chrismerck/autokiln/README.md

# autokiln
Controller for Small Wood-Drying Kilns
