chrismerck/autokiln/hardware/autokiln.pdf

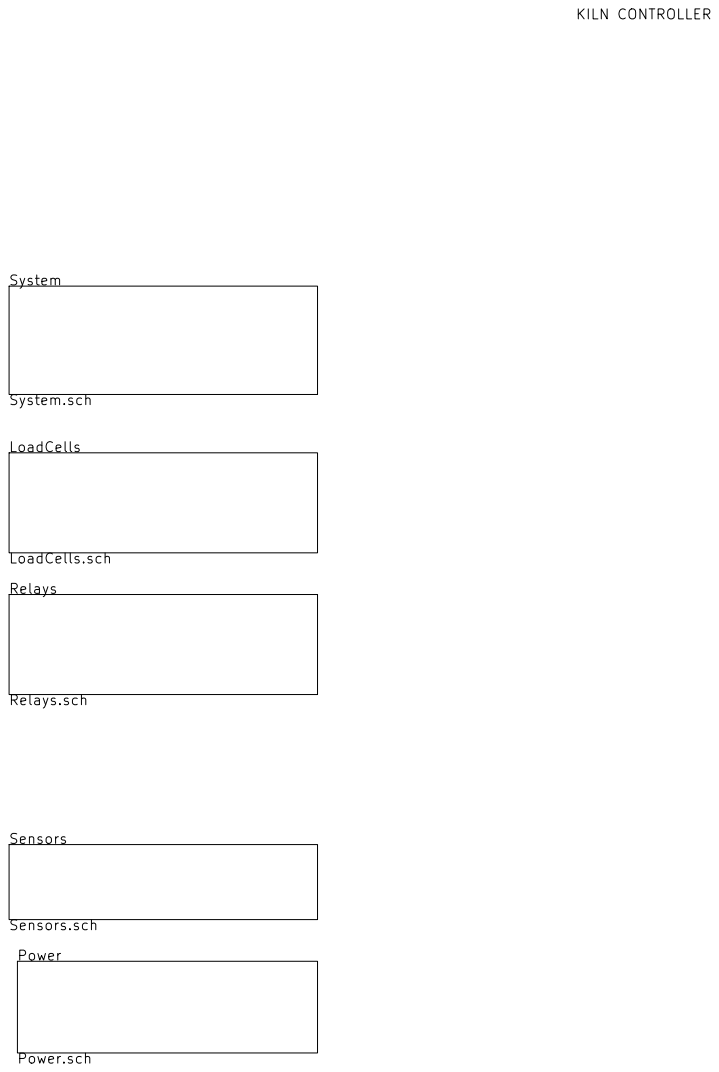
[picture p1: page 1]

Sensors.sch Power Power.sch

File: autokiln.sch Sheet: / Chris Merck

Id: 1/6 Title: Wood Drying Kiln Controller "AutoKiln"

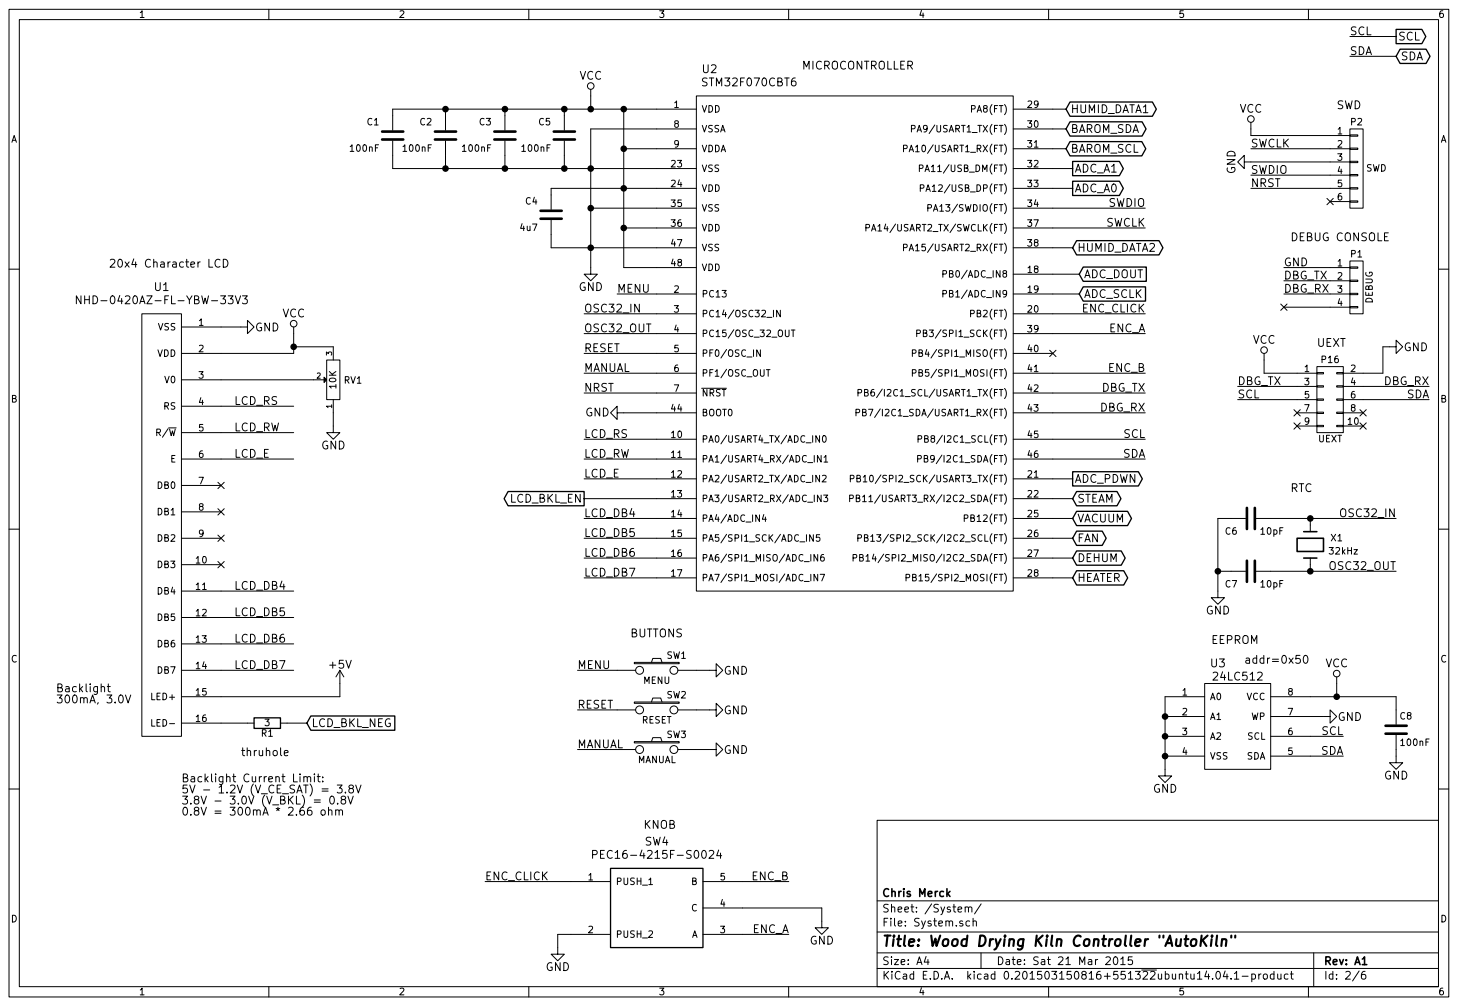
[picture p2: page 2]

thruhole Backlight Current Limit:

Sheet: /System/ Chris Merck

File: System.sch
Id: 2/6 Title: Wood Drying Kiln Controller "AutoKiln"

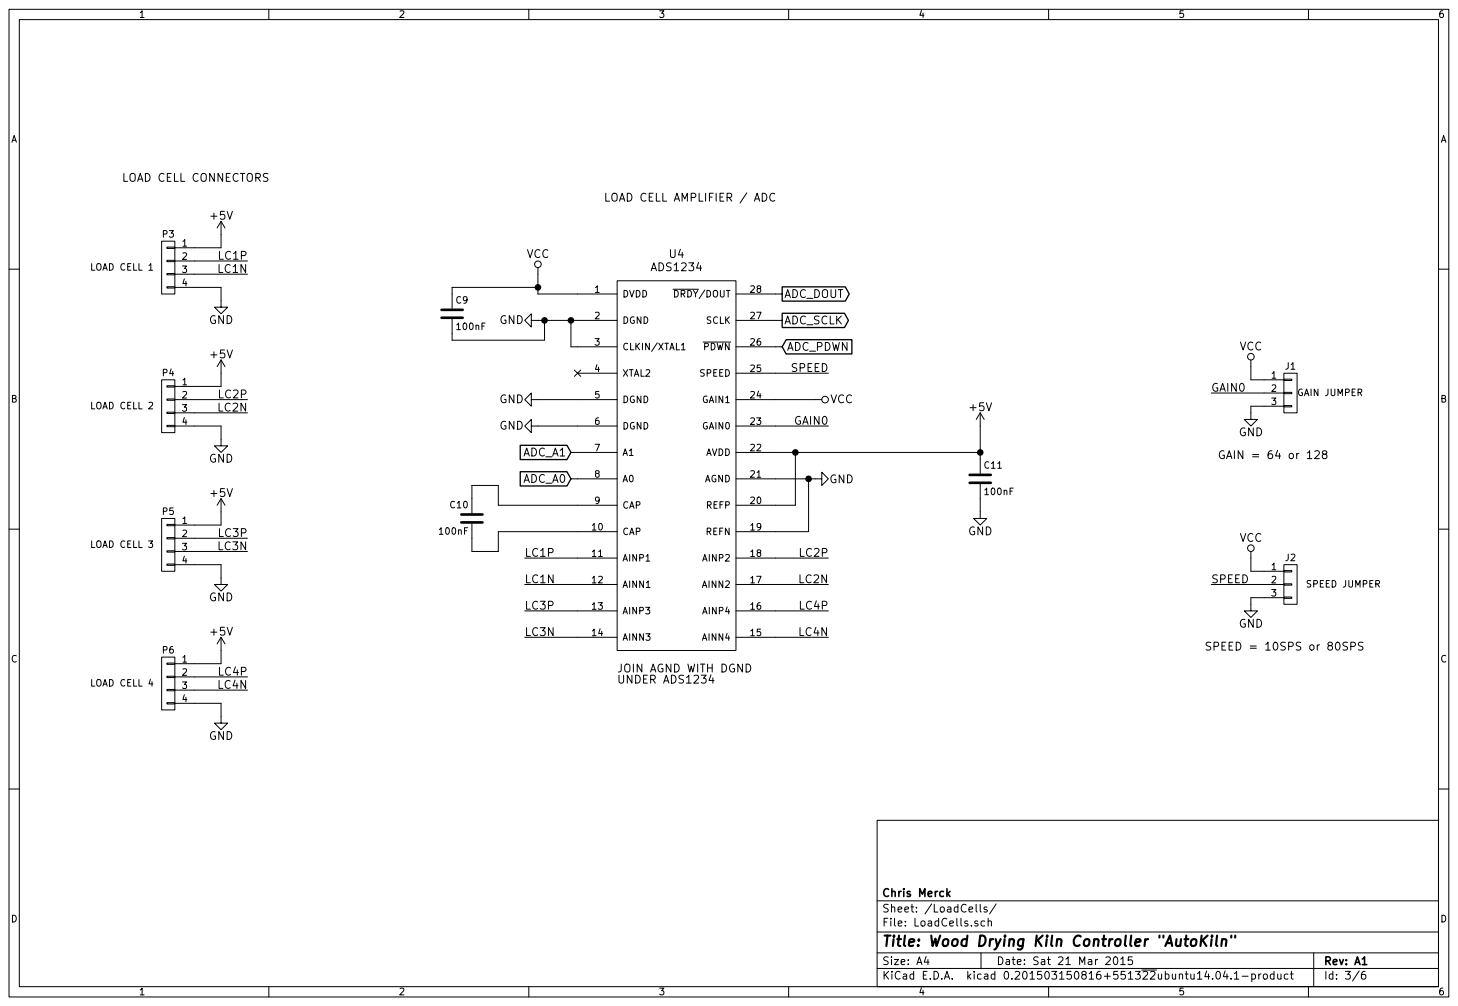
[picture p3: page 3]

LOAD CELL AMPLIFIER / ADC

JOIN AGND WITH DGND
UNDER ADS1234

File: LoadCells.sch Sheet: /LoadCells/ Chris Merck

Id: 3/6 Title: Wood Drying Kiln Controller "AutoKiln"

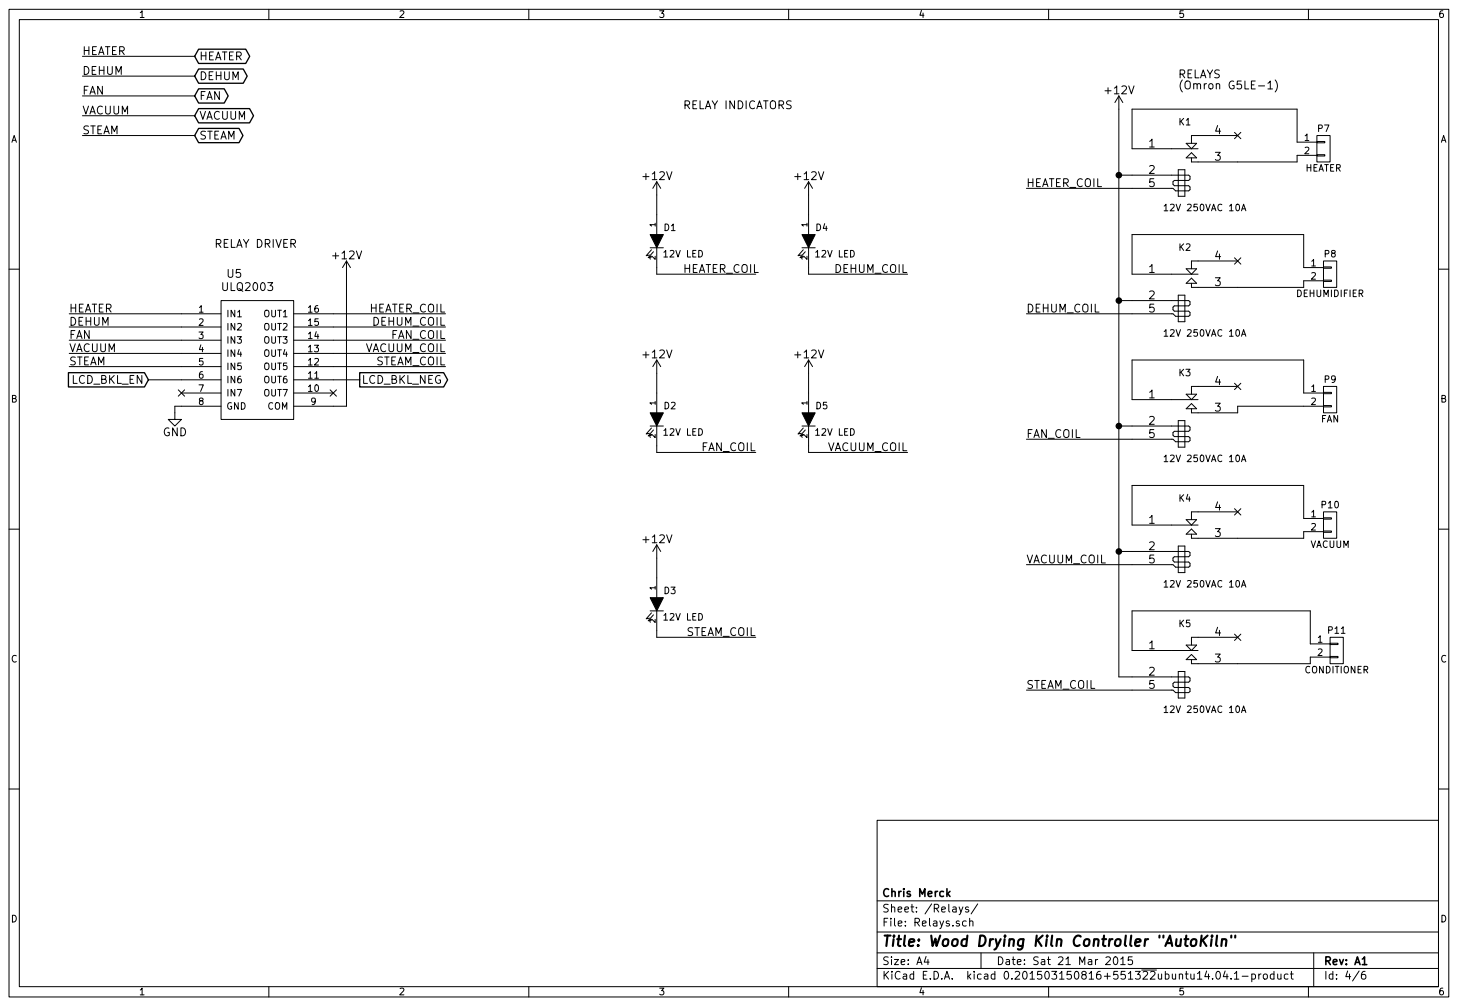
[picture p4: page 4]

FAN | IN3 3 | | FAN_COIL

IN4 4 | VACUUM_COIL

STEAM_COIL

Sheet: /Relays/ Chris Merck

File: Relays.sch
Id: 4/6 Title: Wood Drying Kiln Controller "AutoKiln"

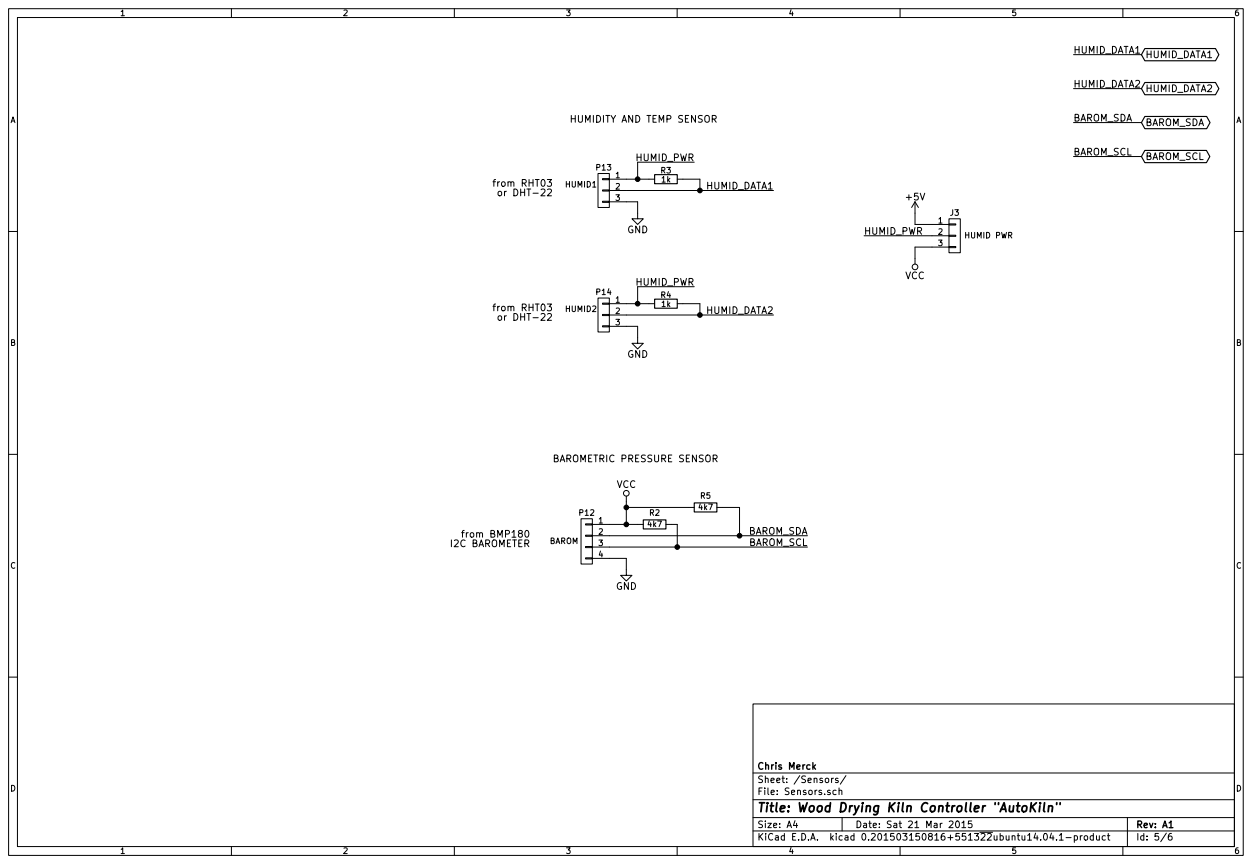
[picture p5: page 5]

HUMIDITY AND TEMP SENSOR

File: Sensors.sch Sheet: /Sensors/ Chris Merck

Id: 5/6 Title: Wood Drying Kiln Controller "AutoKiln"

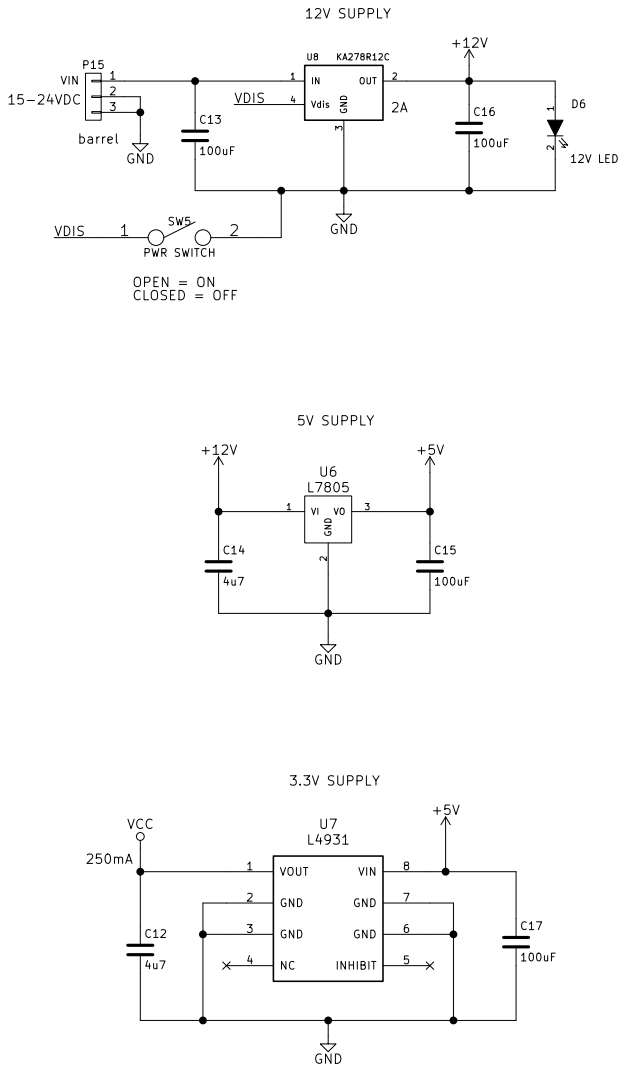
[picture p6: page 6]

File: Power.sch Sheet: /Power/ Chris Merck

Id: 6/6 Title: Wood Drying Kiln Controller "AutoKiln"
