chrismerck/autokiln/hardware/autokiln.kicad_pcb

## KiCad design hardware/autokiln.kicad_pcb (2015-04-01)

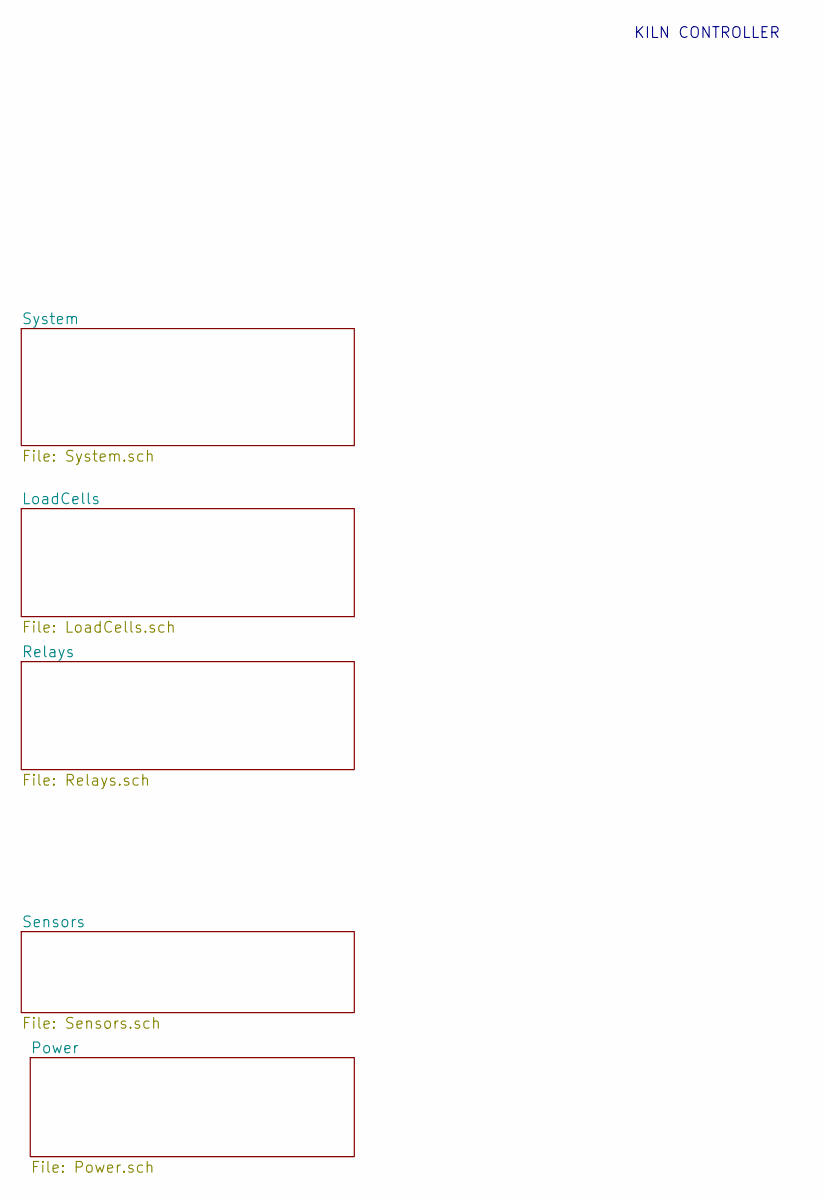
[picture p7: schematic autokiln.sch, Wood Drying Kiln Controller \"AutoKiln\"]

Notes on the sheet:
KILN CONTROLLER

Schematic: System.sch, Wood Drying Kiln Controller \"AutoKiln\"

Parts:
C1, C2, C3, C5, C8: 100nF; R_0805_HandSoldering
C4: 4u7; R_0805_HandSoldering
C6, C7: 10pF; R_0805_HandSoldering
P1: DEBUG; Pin_Header_Straight_1x04
P2: SWD; Pin_Header_Straight_1x06
P16: UEXT; Pin_Header_Straight_2x05
R1: 3; Resistor_Horizontal_RM10mm
RV1: 10K; BOURNS_TRIMMER_3303W
SW1: MENU; CK_Button_D6R
SW2: RESET; CK_Button_D6R
SW3: MANUAL; CK_Button_D6R
SW4: PEC16-4215F-S0024; BOURNS_Encoder_PEC16
U1: NHD-0420AZ-FL-YBW-33V3; NHD-0420AZ-FL-GBW-33V3
U2: STM32F070CBT6; LQFP-48_7x7mm_Pitch0.5mm
U3: 24LC512; SOIC-8_3.9x4.9mm_Pitch1.27mm
X1: 32kHz; Abracon_32KHz

Connections:
+5V: U1.15 (LED+); also elsewhere on the board
/System/DBG_RX: P1.3, P16.4, U2.43 (PB7/I2C1_SDA/USART1_RX(FT))
/System/DBG_TX: P1.2, P16.3, U2.42 (PB6/I2C1_SCL/USART1_TX(FT))
/System/ENC_A: SW4.3 (A), U2.39 (PB3/SPI1_SCK(FT))
/System/ENC_B: SW4.5 (B), U2.41 (PB5/SPI1_MOSI(FT))
/System/ENC_CLICK: SW4.1 (PUSH_1), U2.20 (PB2(FT))
/System/LCD_DB4: U1.11 (DB4), U2.14 (PA4/ADC_IN4)
/System/LCD_DB5: U1.12 (DB5), U2.15 (PA5/SPI1_SCK/ADC_IN5)
/System/LCD_DB6: U1.13 (DB6), U2.16 (PA6/SPI1_MISO/ADC_IN6)
/System/LCD_DB7: U1.14 (DB7), U2.17 (PA7/SPI1_MOSI/ADC_IN7)
/System/LCD_E: U1.6 (E), U2.12 (PA2/USART2_TX/ADC_IN2)
/System/LCD_RS: U1.4 (RS), U2.10 (PA0/USART4_TX/ADC_IN0)
/System/LCD_RW: U1.5 (R/~W), U2.11 (PA1/USART4_RX/ADC_IN1)
/System/MANUAL: SW3.1, U2.6 (PF1/OSC_OUT)
/System/MENU: SW1.1, U2.2 (PC13)
/System/NRST: P2.5, U2.7 (~NRST)
/System/OSC32_IN: C6.2, U2.3 (PC14/OSC32_IN), X1.1
/System/OSC32_OUT: C7.2, U2.4 (PC15/OSC_32_OUT), X1.2
/System/RESET: SW2.1, U2.5 (PF0/OSC_IN)
/System/SWCLK: P2.2, U2.37 (PA14/USART2_TX/SWCLK(FT))
/System/SWDIO: P2.4, U2.34 (PA13/SWDIO(FT))
ADC_A0: U2.33 (PA12/USB_DP(FT)); also elsewhere on the board
ADC_A1: U2.32 (PA11/USB_DM(FT)); also elsewhere on the board
ADC_DOUT: U2.18 (PB0/ADC_IN8); also elsewhere on the board
ADC_PDWN: U2.21 (PB10/SPI2_SCK/USART3_TX(FT)); also elsewhere on the board
ADC_SCLK: U2.19 (PB1/ADC_IN9); also elsewhere on the board
BAROM_SCL: U2.31 (PA10/USART1_RX(FT)); also elsewhere on the board
BAROM_SDA: U2.30 (PA9/USART1_TX(FT)); also elsewhere on the board
DEHUM: U2.27 (PB14/SPI2_MISO/I2C2_SDA(FT)); also elsewhere on the board
FAN: U2.26 (PB13/SPI2_SCK/I2C2_SCL(FT)); also elsewhere on the board
GND: C1.2, C2.2, C3.2, C4.2, C5.2, C6.1, C7.1, C8.2, P1.1, P2.3, P16.2, RV1.1, SW1.2, SW2.2, SW3.2, SW4.2 (PUSH_2), SW4.4 (C), U1.1 (VSS), U2.8 (VSSA), U2.23 (VSS), U2.35 (VSS), U2.44 (BOOT0), U2.47 (VSS), U3.1 (A0), U3.2 (A1), U3.3 (A2), U3.4 (VSS), U3.7 (WP); also elsewhere on the board
HEATER: U2.28 (PB15/SPI2_MOSI(FT)); also elsewhere on the board
HUMID_DATA1: U2.29 (PA8(FT)); also elsewhere on the board
HUMID_DATA2: U2.38 (PA15/USART2_RX(FT)); also elsewhere on the board
LCD_BKL_EN: U2.13 (PA3/USART2_RX/ADC_IN3); also elsewhere on the board
LCD_BKL_NEG: R1.1; also elsewhere on the board
unnamed: R1.2, U1.16 (LED-)
unnamed: RV1.2, U1.3 (V0)
SCL: P16.5, U2.45 (PB8/I2C1_SCL(FT)), U3.6 (SCL)
SDA: P16.6, U2.46 (PB9/I2C1_SDA(FT)), U3.5 (SDA)
STEAM: U2.22 (PB11/USART3_RX/I2C2_SDA(FT)); also elsewhere on the board
VACUUM: U2.25 (PB12(FT)); also elsewhere on the board
VCC: C1.1, C2.1, C3.1, C4.1, C5.1, C8.1, P2.1, P16.1, RV1.3, U1.2 (VDD), U2.1 (VDD), U2.9 (VDDA), U2.24 (VDD), U2.36 (VDD), U2.48 (VDD), U3.8 (VCC); also elsewhere on the board

Notes on the sheet:
MICROCONTROLLER
EEPROM
addr=0x50
RTC
DEBUG CONSOLE
KNOB
SWD
BUTTONS
Backlight 300mA, 3.0V
20x4 Character LCD
thruhole
Backlight Current Limit: 5V - 1.2V (V_CE_SAT) = 3.8V 3.8V - 3.0V (V_BKL) = 0.8V 0.8V = 300mA * 2.66 ohm
UEXT

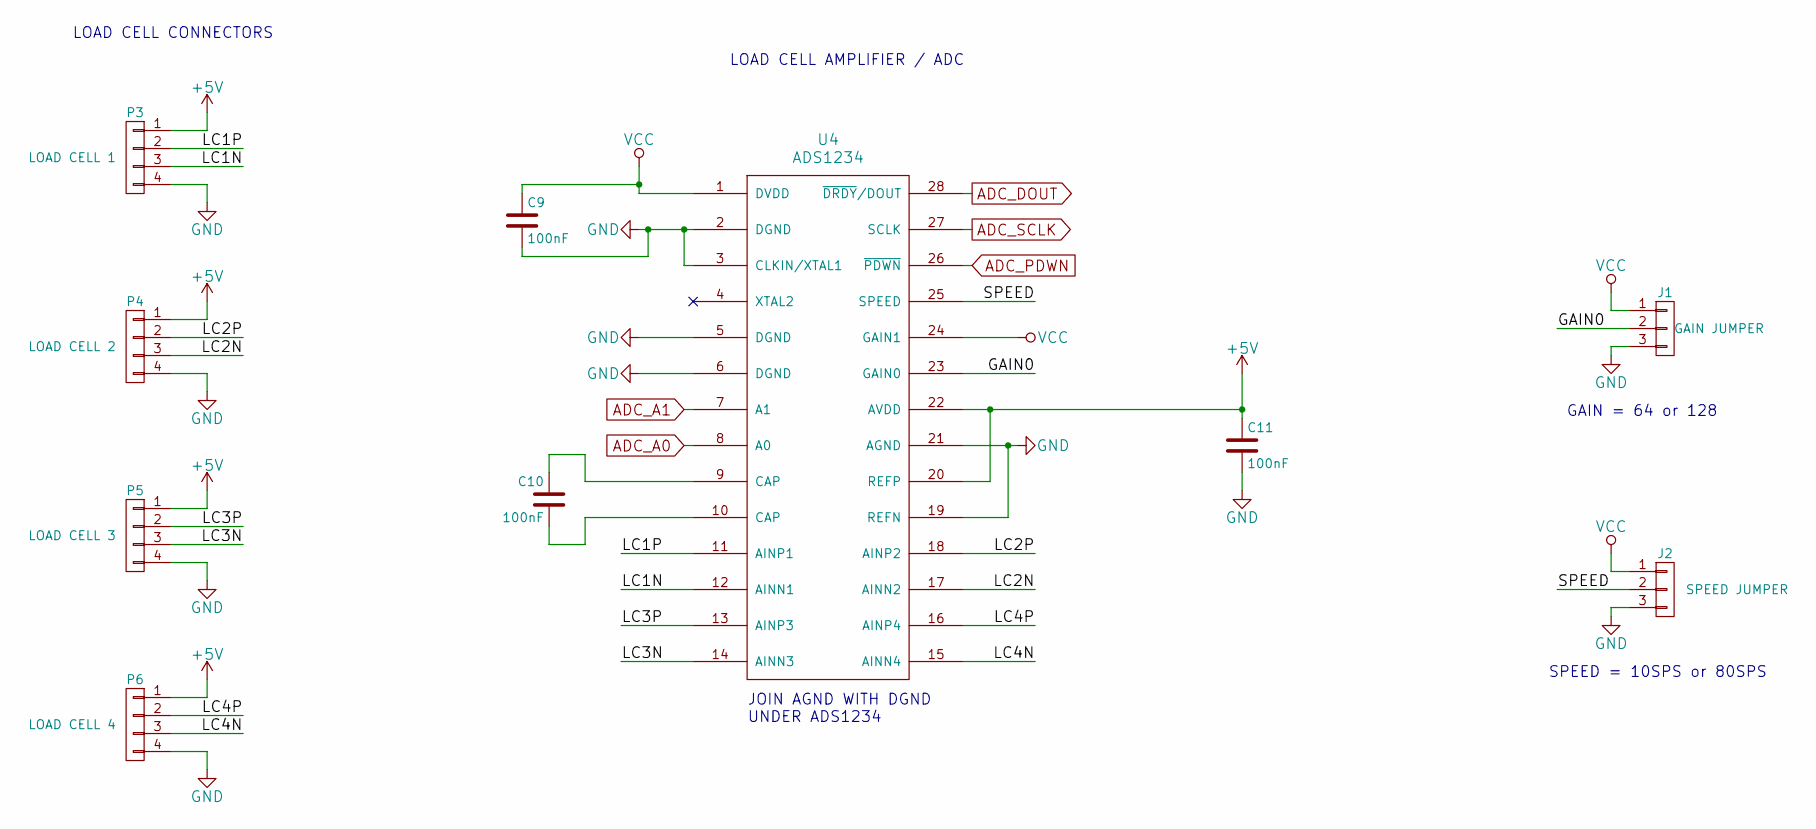
[picture p8: schematic LoadCells.sch, Wood Drying Kiln Controller \"AutoKiln\"]

Parts:
C9, C10, C11: 100nF; R_0805_HandSoldering
J1: GAIN JUMPER; Pin_Header_Straight_1x03
J2: SPEED JUMPER; Pin_Header_Straight_1x03
P3: LOAD CELL 1; ostoq047151
P4: LOAD CELL 2; ostoq047151
P5: LOAD CELL 3; ostoq047151
P6: LOAD CELL 4; ostoq047151
U4: ADS1234; TSSOP-28_4.4x9.7mm_Pitch0.65mm

Connections:
+5V: C11.1, P3.1, P4.1, P5.1, P6.1, U4.20 (REFP), U4.22 (AVDD); also elsewhere on the board
/LoadCells/GAIN0: J1.2, U4.23 (GAIN0)
/LoadCells/LC1N: P3.3, U4.12 (AINN1)
/LoadCells/LC1P: P3.2, U4.11 (AINP1)
/LoadCells/LC2N: P4.3, U4.17 (AINN2)
/LoadCells/LC2P: P4.2, U4.18 (AINP2)
/LoadCells/LC3N: P5.3, U4.14 (AINN3)
/LoadCells/LC3P: P5.2, U4.13 (AINP3)
/LoadCells/LC4N: P6.3, U4.15 (AINN4)
/LoadCells/LC4P: P6.2, U4.16 (AINP4)
/LoadCells/SPEED: J2.2, U4.25 (SPEED)
ADC_A0: U4.8 (A0); also elsewhere on the board
ADC_A1: U4.7 (A1); also elsewhere on the board
ADC_DOUT: U4.28 (~DRDY~/DOUT); also elsewhere on the board
ADC_PDWN: U4.26 (~PDWN); also elsewhere on the board
ADC_SCLK: U4.27 (SCLK); also elsewhere on the board
GND: C9.2, C11.2, J1.3, J2.3, P3.4, P4.4, P5.4, P6.4, U4.2 (DGND), U4.3 (CLKIN/XTAL1), U4.5 (DGND), U4.6 (DGND), U4.19 (REFN), U4.21 (AGND); also elsewhere on the board
unnamed: C10.1, U4.9 (CAP)
unnamed: C10.2, U4.10 (CAP)
VCC: C9.1, J1.1, J2.1, U4.1 (DVDD), U4.24 (GAIN1); also elsewhere on the board

Notes on the sheet:
JOIN AGND WITH DGND UNDER ADS1234
GAIN = 64 or 128
LOAD CELL CONNECTORS
LOAD CELL AMPLIFIER / ADC
SPEED = 10SPS or 80SPS

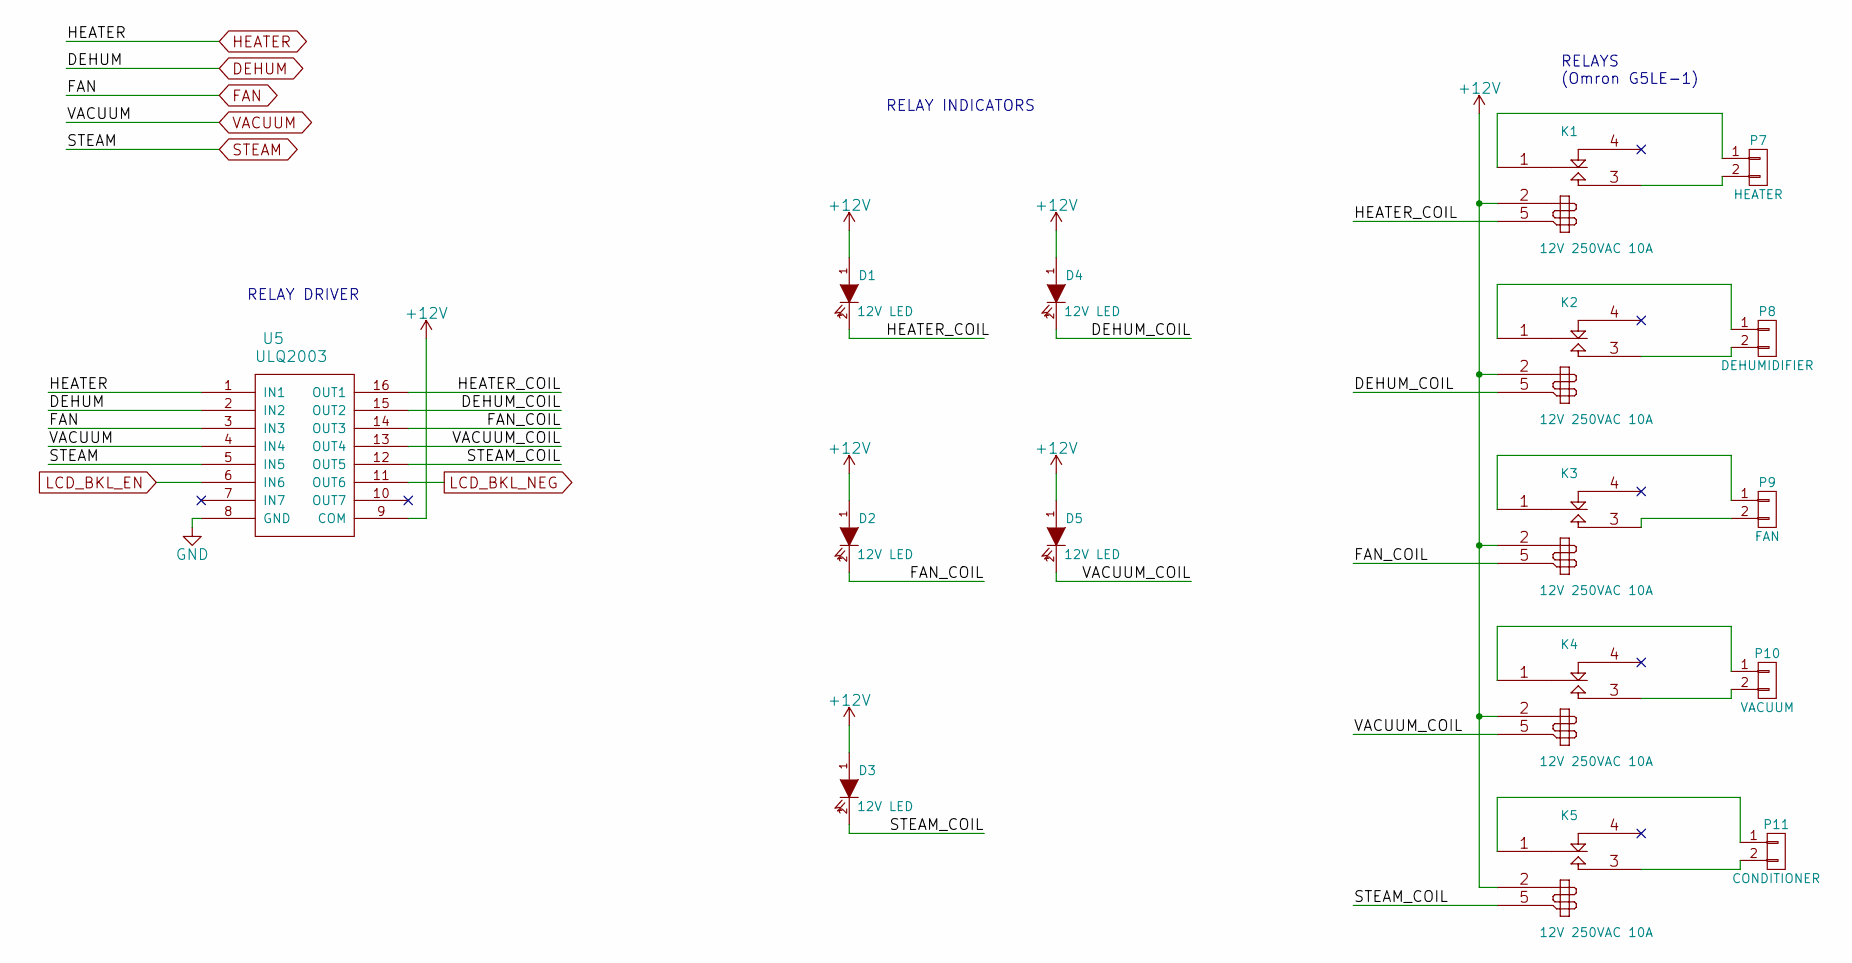
[picture p9: schematic Relays.sch, Wood Drying Kiln Controller \"AutoKiln\"]

Parts:
D1, D2, D3, D4, D5: 12V LED; Diode_LED_5mm_round_vertical
K1, K2, K3, K4, K5: 12V 250VAC 10A; Relay_SANYOU_SRD_Series_Form_C
P7: HEATER; OSTOQ020151
P8: DEHUMIDIFIER; OSTOQ020151
P9: FAN; OSTOQ020151
P10: VACUUM; OSTOQ020151
P11: CONDITIONER; OSTOQ020151
U5: ULQ2003; SO-16-N

Connections:
+12V: D1.1 (A), D2.1 (A), D3.1 (A), D4.1 (A), D5.1 (A), K1.2, K2.2, K3.2, K4.2, K5.2, U5.9 (COM); also elsewhere on the board
/Relays/DEHUM_COIL: D4.2 (K), K2.5, U5.15 (OUT2)
/Relays/FAN_COIL: D2.2 (K), K3.5, U5.14 (OUT3)
/Relays/HEATER_COIL: D1.2 (K), K1.5, U5.16 (OUT1)
/Relays/STEAM_COIL: D3.2 (K), K5.5, U5.12 (OUT5)
/Relays/VACUUM_COIL: D5.2 (K), K4.5, U5.13 (OUT4)
DEHUM: U5.2 (IN2); also elsewhere on the board
FAN: U5.3 (IN3); also elsewhere on the board
GND: U5.8 (GND); also elsewhere on the board
HEATER: U5.1 (IN1); also elsewhere on the board
LCD_BKL_EN: U5.6 (IN6); also elsewhere on the board
LCD_BKL_NEG: U5.11 (OUT6); also elsewhere on the board
unnamed: K1.1, P7.1
unnamed: K1.3, P7.2
unnamed: K2.1, P8.1
unnamed: K2.3, P8.2
unnamed: K3.1, P9.1
unnamed: K3.3, P9.2
unnamed: K4.1, P10.1
unnamed: K4.3, P10.2
unnamed: K5.1, P11.1
unnamed: K5.3, P11.2
STEAM: U5.5 (IN5); also elsewhere on the board
VACUUM: U5.4 (IN4); also elsewhere on the board

Notes on the sheet:
RELAYS (Omron G5LE-1)
RELAY DRIVER
RELAY INDICATORS

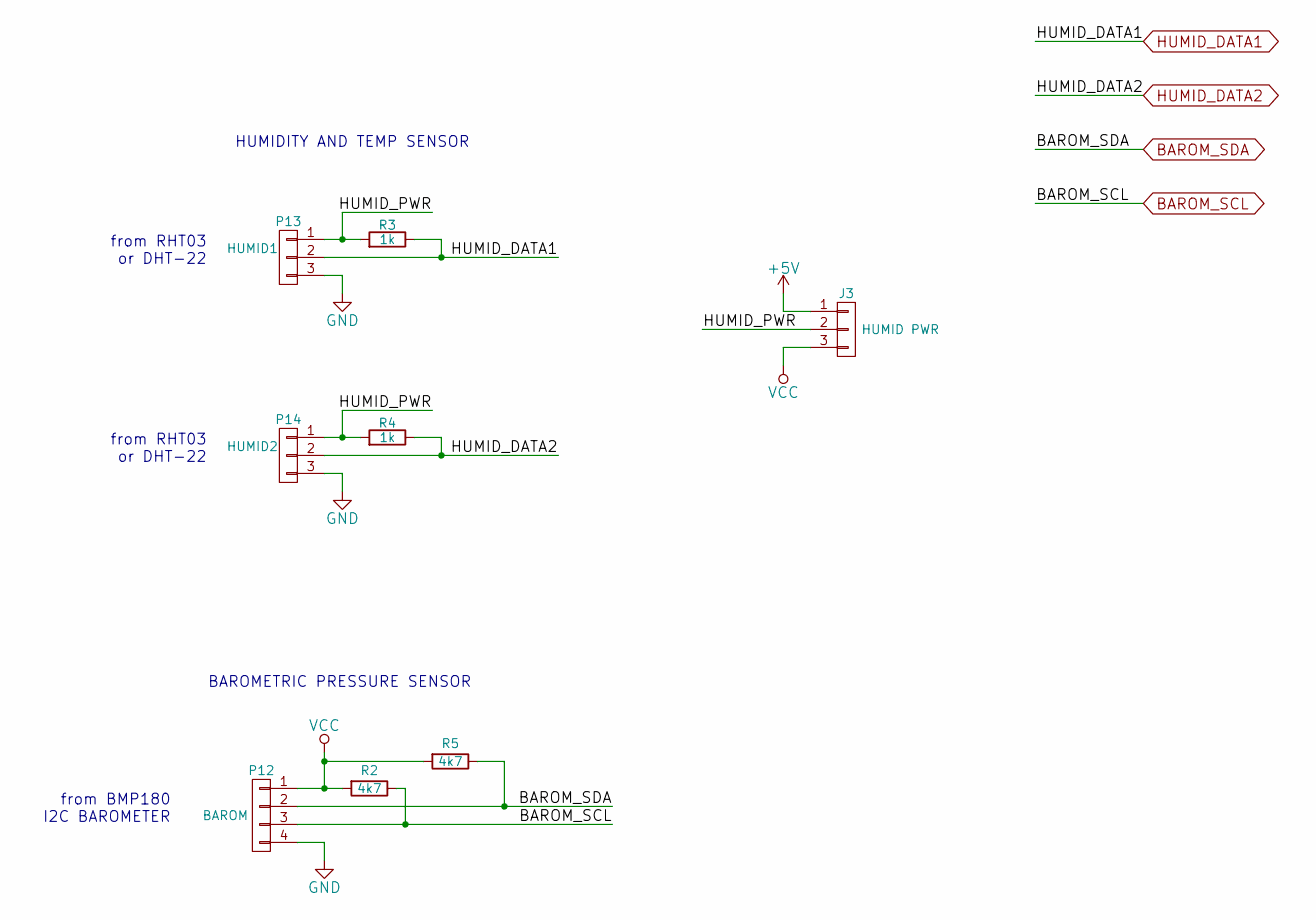
[picture p10: schematic Sensors.sch, Wood Drying Kiln Controller \"AutoKiln\"]

Parts:
J3: HUMID PWR; Pin_Header_Straight_1x03
P12: BAROM; ostoq047151
P13: HUMID1; OSTOQ037151
P14: HUMID2; OSTOQ037151
R2, R5: 4k7; R_0805_HandSoldering
R3, R4: 1k; R_0805_HandSoldering

Connections:
+5V: J3.1; also elsewhere on the board
/Sensors/HUMID_PWR: J3.2, P13.1, P14.1, R3.2, R4.2
BAROM_SCL: P12.3, R2.1; also elsewhere on the board
BAROM_SDA: P12.2, R5.1; also elsewhere on the board
GND: P12.4, P13.3, P14.3; also elsewhere on the board
HUMID_DATA1: P13.2, R3.1; also elsewhere on the board
HUMID_DATA2: P14.2, R4.1; also elsewhere on the board
VCC: J3.3, P12.1, R2.2, R5.2; also elsewhere on the board

Notes on the sheet:
from RHT03 or DHT-22
HUMIDITY AND TEMP SENSOR
from BMP180 I2C BAROMETER
BAROMETRIC PRESSURE SENSOR

Schematic: Power.sch, Wood Drying Kiln Controller \"AutoKiln\"

Parts:
C12, C14: 4u7; R_0805_HandSoldering
C13, C15, C16, C17: 100uF; KEMET_100uF_25V
D6: 12V LED; Diode_LED_5mm_round_vertical
P15: VIN; CUI_PJ-002AH_DC_PWR_JACK
SW5: PWR SWITCH; ESwitch-100SP1T1B4M2QE
U6: L7805; TO-220_SG
U7: L4931; SO-8
U8: KA278R12C; TO-220F-4L

Connections:
+5V: C15.1, C17.1, U6.3, U7.8 (VIN); also elsewhere on the board
+12V: C14.1, C16.1, D6.1 (A), U6.1, U8.2 (OUT); also elsewhere on the board
/Power/VDIS: SW5.1, U8.4 (Vdis)
GND: C12.2, C13.2, C14.2, C15.2, C16.2, C17.2, D6.2 (K), P15.2, P15.3, SW5.2, U6.2, U7.2 (GND), U7.3 (GND), U7.6 (GND), U7.7 (GND), U8.3 (GND); also elsewhere on the board
unnamed: C13.1, P15.1, U8.1 (IN)
VCC: C12.1, U7.1 (VOUT); also elsewhere on the board

Notes on the sheet:
15-24VDC
OPEN = ON CLOSED = OFF
12V SUPPLY
250mA
3.3V SUPPLY
5V SUPPLY
barrel

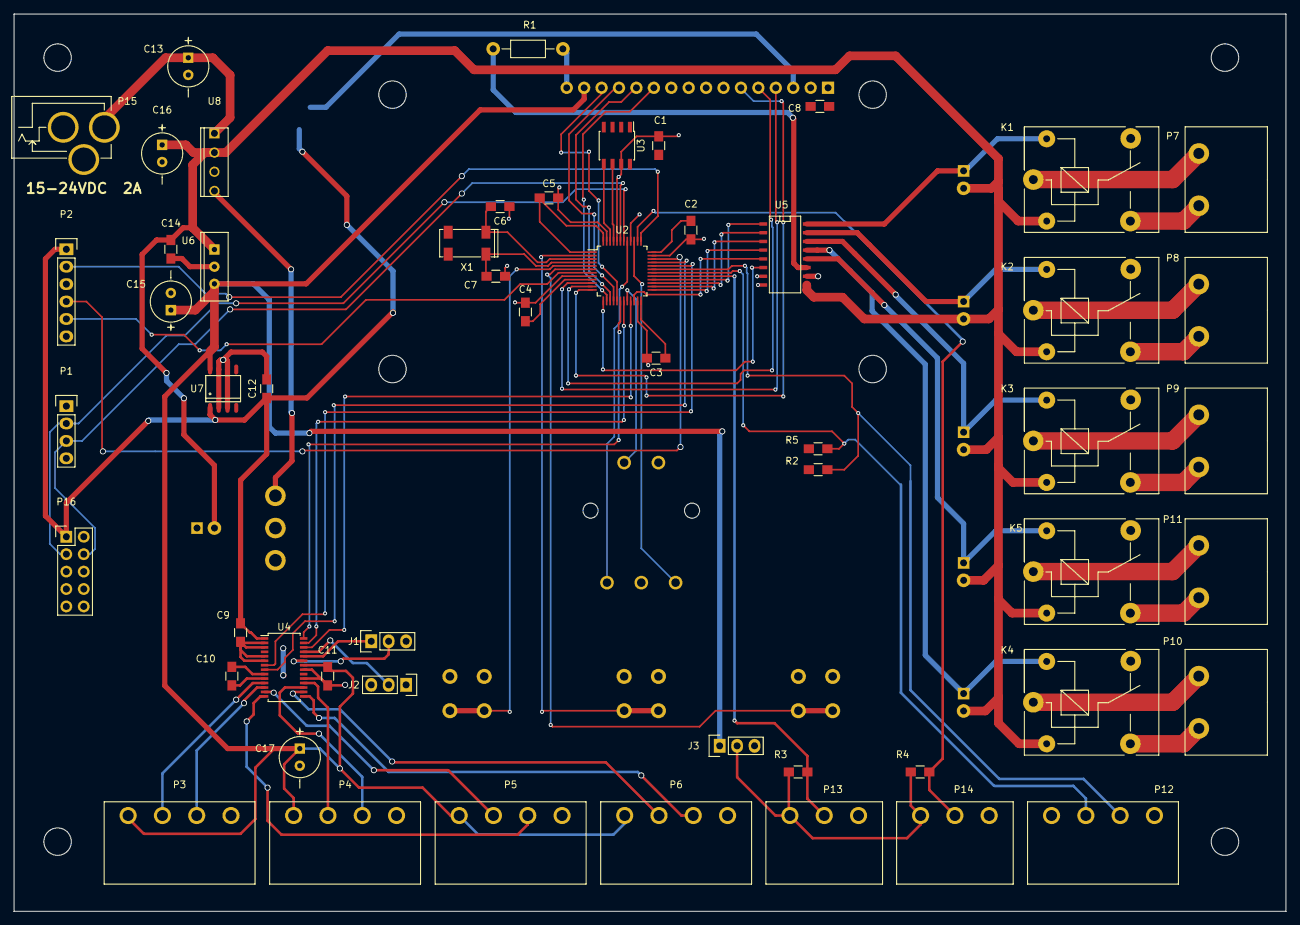
[picture p11: board autokiln.kicad_pcb from above]

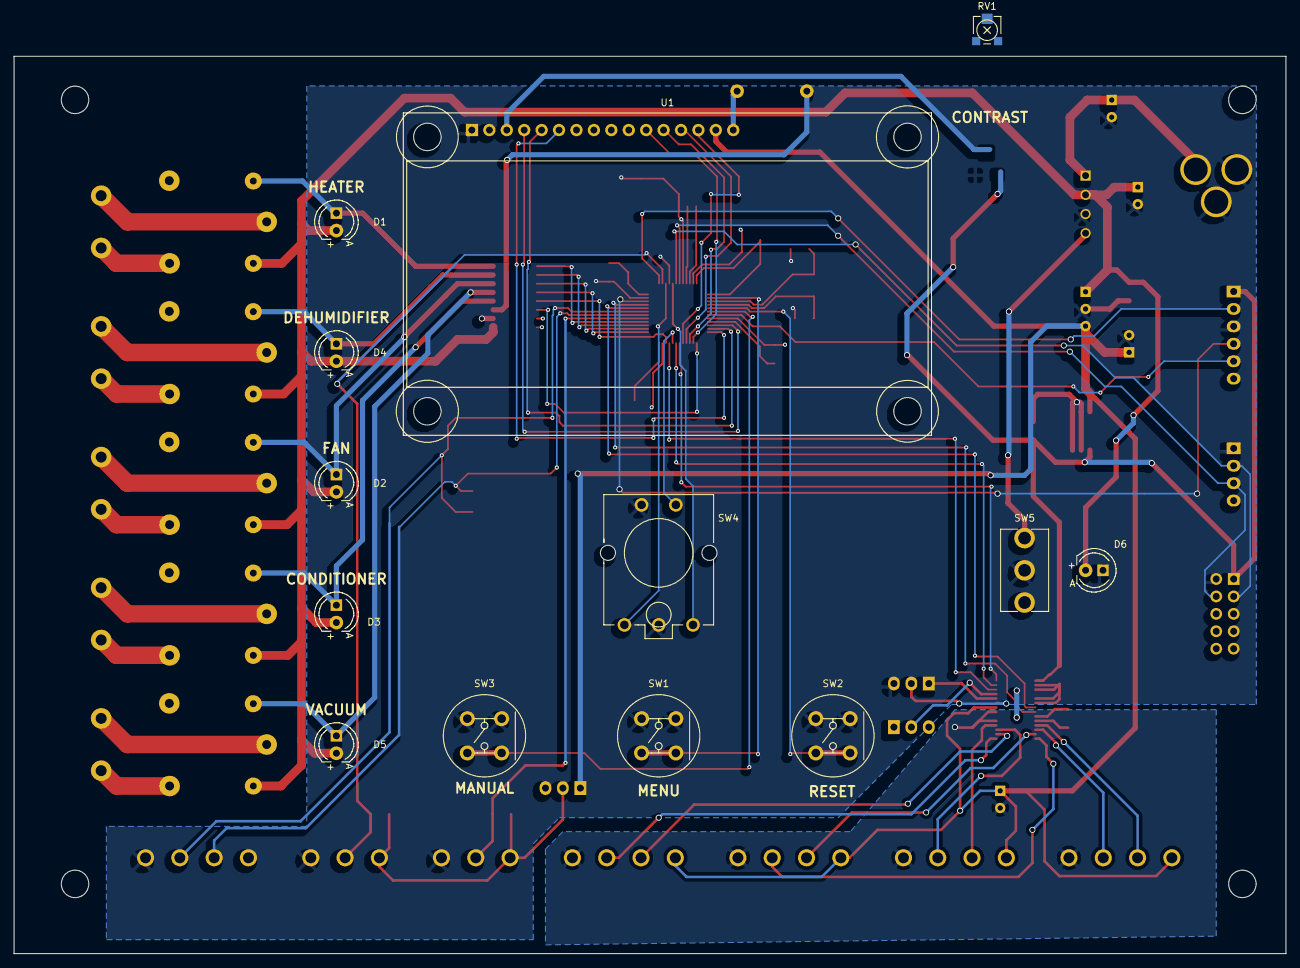
[picture p12: board autokiln.kicad_pcb from below]

Board: 2 copper layers, 185.4 x 130.8 mm, 67 parts (13 on the bottom side), 74 nets.
