chrismerck/autokiln/firmware/autokiln/LCD.h

#ifndef __LCD_H__
#define __LCD_H__

#define LCD_XMAX 20
#define LCD_YMAX 4

#define LCD_NUM_BUF 1


extern uint8_t lcd_buf[LCD_XMAX*LCD_YMAX*LCD_NUM_BUF];

void LCD_Init();
uint8_t * LCD_GetBuf();
void LCD_Redraw();
void LCD_Test();
void LCD_ClearBuffer();
void LCD_SetCursor(int32_t x, int32_t y);

void LCD_Backlight_Wake();
void LCD_Backlight_Tick();
void LCD_Backlight_Set(uint16_t brightness);

#endif 
