chrismerck/autokiln/firmware/autokiln/ImageInfo.h

#ifndef __IMAGE_INFO_H__
#define __IMAGE_INFO_H__

/***
 * Information About the Firmware Image File
 ***/

#define IMAGE_NAME      "AUTOKILN-APP"

#define IMAGE_VERSION     "0.1.0-dev"
#define IMAGE_COMMIT      0x00000000 /** automatically updated by mk-img **/

#define IMAGE_DATETIME  __DATE__ " " __TIME__

#endif //__IMAGE_INFO_H__
