chrismerck/autokiln/firmware/autokiln/tinynew.cpp

/* tinynew.cpp
   
   Overrides operators new and delete
   globally to reduce code size.
   
   Public domain, use however you wish.
   If you really need a license, consider it MIT:
   http://www.opensource.org/licenses/mit-license.php
   
   - Eric Agan
     Elegant Invention
 */

#include <new>
#include "ch.h"

void* operator new(std::size_t size) {
    return chHeapAlloc(NULL, size);
}

void* operator new[](std::size_t size) {
    return chHeapAlloc(NULL, size);
}

void operator delete(void* ptr) {
    chHeapFree(ptr);
}

void operator delete[](void* ptr) {
    chHeapFree(ptr);
}

/* Optionally you can override the 'nothrow' versions as well.
   This is useful if you want to catch failed allocs with your
   own debug code, or keep track of heap usage for example,
   rather than just eliminate exceptions.
 */

void* operator new(std::size_t size, const std::nothrow_t&) {
    return chHeapAlloc(NULL, size);
}

void* operator new[](std::size_t size, const std::nothrow_t&) {
    return chHeapAlloc(NULL, size);
}

void operator delete(void* ptr, const std::nothrow_t&) {
    chHeapFree(ptr);
}

void operator delete[](void* ptr, const std::nothrow_t&) {
    chHeapFree(ptr);
}

extern "C" void __cxa_pure_virtual() { chSysHalt("Pure Virtual"); }

namespace __gnu_cxx { void __verbose_terminate_handler() { chSysHalt("Term Handler"); } }

//eof
