chrismerck/autokiln/(commit log)

2015-03-15 AutoKiln: Initial Commit
    Hardware work in progress
    [$UserInterface.sch, LoadCells.sch, Power.sch, Relays.sch, Sensors.sch, System.sch, UserInterface.sch, autokiln.sch]
2015-03-21 Schematic Draft Complete
    [LoadCells.sch, Power.sch, Relays.sch, Sensors.sch, System.sch, autokiln.sch]
2015-03-22 PCB mostly routed
    [LoadCells.sch, Power.sch, Relays.sch, Sensors.sch, System.sch, autokiln.csv, autokiln.kicad_pcb, autokiln.sch]
2015-04-01 PCB updates [wip]
    [autokiln.kicad_pcb]
2015-06-04 Autokiln Hardware Rev A
    [Relays.sch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]
2015-07-04 Input Events
    Buttons incl. encoder click working
    moving to event-driven design
2015-07-04 Fix LCD line order, splash screen
    [LCD.cpp, main.cpp]
2015-07-11 Working interrupt for Encoder
2015-07-11 Encoder working (using ISR)
    still need to clean up code
2015-07-11 Send pulses to Humid sensors
    next need to write code to intepret response
2015-07-14 Humid: almost working
    missing some interrupts, need to refactor
    [Humid.cpp, Humid.h, Input.cpp]
2015-07-14 Humid working
    switched from multiple interrupts to single busy loop
    (introduces up to 10ms of latency!!!
2015-07-14 Humid: both sensors working
2015-07-15 ADS1234: Weigh Scale ADC Driver Initial Commit
    can read channel 0
2015-07-18 LCD Backlight PWM
    wake, warn, and sleep the backlight
2015-10-04 Fix Humid checksum calculation
    [Humid.cpp, Humid.h, Menu.cpp]
